Xuxiupa/dual-mcu-sorter/docs/数据流时序图.png

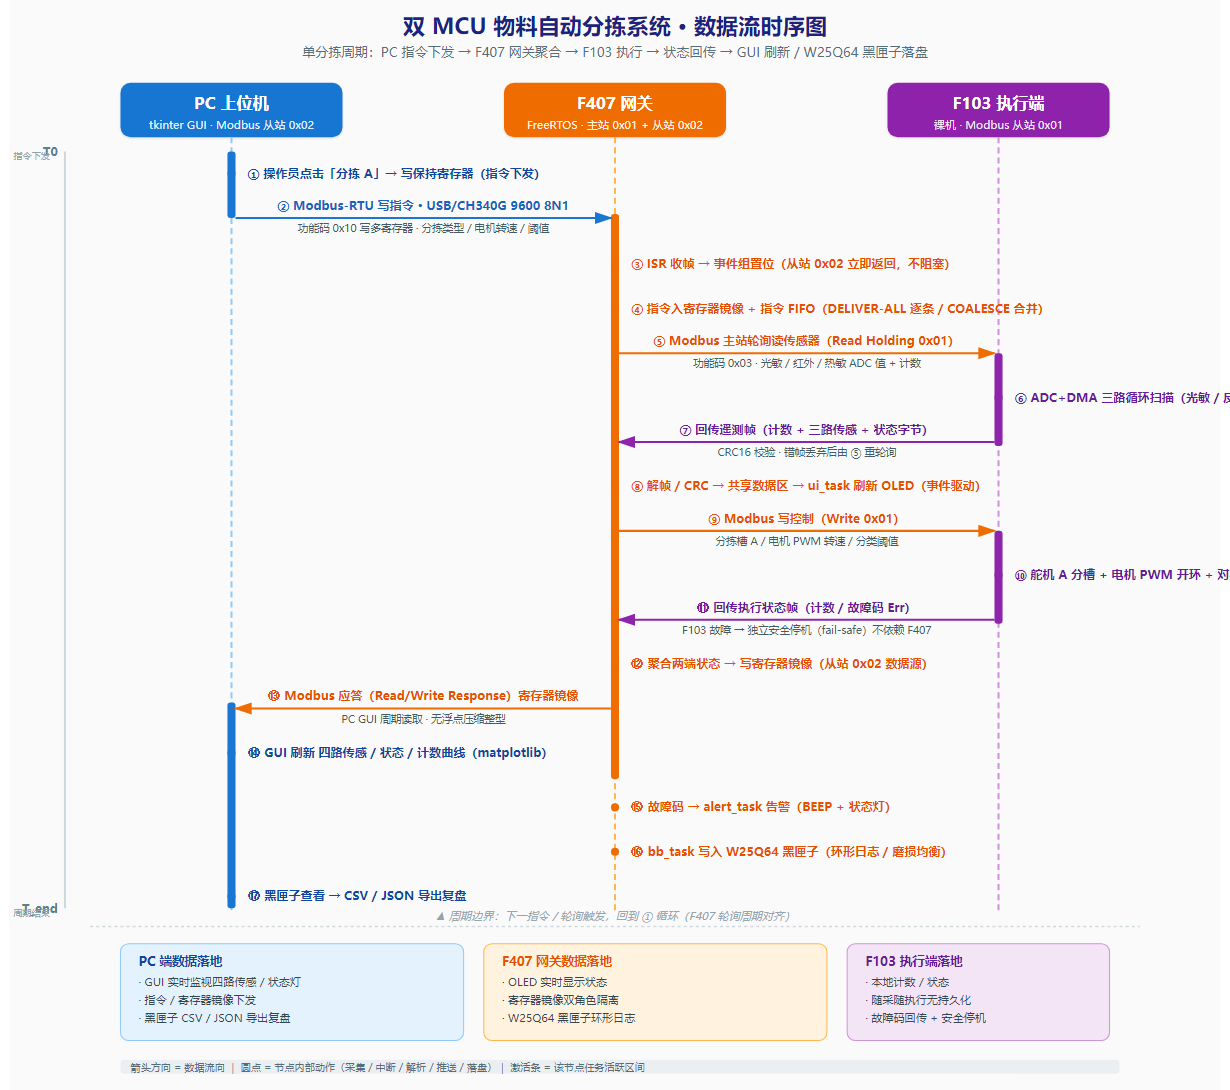
docs/数据流时序图.png
