Xuxiupa/dual-mcu-sorter/docs/架构图.png

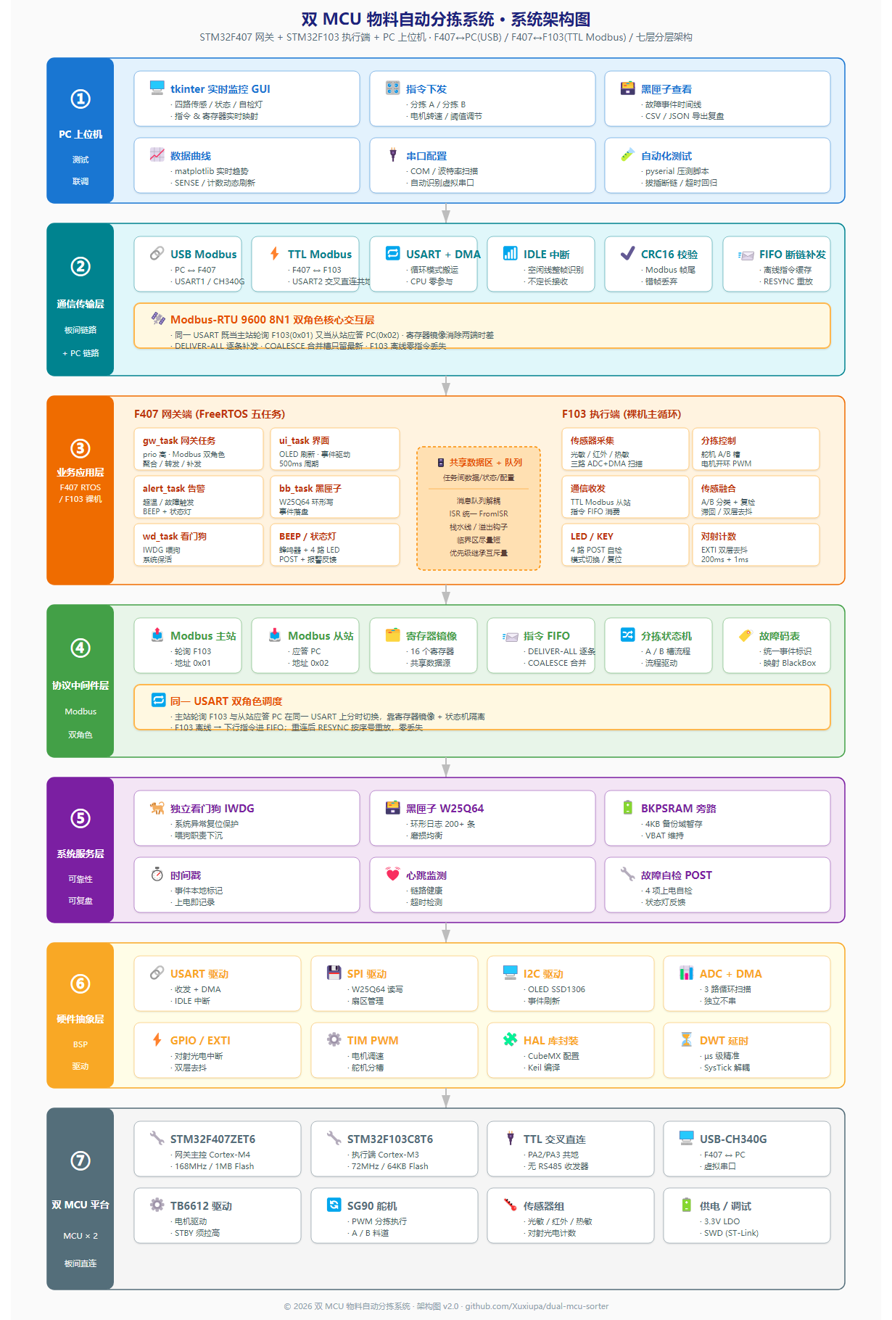
docs/架构图.png
