Xuxiupa/dual-mcu-sorter/f103_executor/Core/Inc/main.h

#define ENCODER_A_Pin GPIO_PIN_0
#define ENCODER_A_GPIO_Port GPIOA
#define ENCODER_B_Pin GPIO_PIN_1
#define ENCODER_B_GPIO_Port GPIOA
#define ADC_IN_BAT_Pin GPIO_PIN_4
#define ADC_IN_BAT_GPIO_Port GPIOA
#define PWM_SERVO_Pin GPIO_PIN_6
#define PWM_SERVO_GPIO_Port GPIOA
#define PWM_MOTOR_Pin GPIO_PIN_8
#define PWM_MOTOR_GPIO_Port GPIOA
#define KEY_INT_Pin GPIO_PIN_12
#define KEY_INT_GPIO_Port GPIOA
#define KEY_INT_EXTI_IRQn EXTI15_10_IRQn
#define LED1_Pin GPIO_PIN_3
#define LED1_GPIO_Port GPIOB
#define LED2_Pin GPIO_PIN_4
#define LED2_GPIO_Port GPIOB
#define BEEP_Pin GPIO_PIN_5
#define BEEP_GPIO_Port GPIOB
#define BEEPB6_Pin GPIO_PIN_6
#define BEEPB6_GPIO_Port GPIOB
