Xuxiupa/dual-mcu-sorter/f103_executor/Core/Src/main.c

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
/* Includes ------------------------------------------------------------------*/
#include "main.h"
#include "adc.h"
#include "dma.h"
#include "iwdg.h"
#include "tim.h"
#include "usart.h"
#include "gpio.h"

/* USER CODE BEGIN Includes */
#include <stdio.h>   /* fputc 里的 FILE *f 需要 */
#include "app_main.h"

/* USER CODE END Includes */


void SystemClock_Config(void);
/* USER CODE BEGIN 0 */


int fputc(int ch, FILE *f)
{
    HAL_UART_Transmit(&huart1, (uint8_t *)&ch,1,0xFFFF);
    return ch;
}


/* USER CODE END 0 */

/**
  * @brief  The application entry point.
  * @retval int
  */
int main(void)
{

  /* USER CODE BEGIN 1 */
  /* 释放 PB3/PB4 的 JTAG 功能，改作普通 GPIO（电机方向脚 AIN1/AIN2 用）。
     注意：只关 JTAG、保留 SWD(PA13/PA14)，否则无法再调试下载。 */
  __HAL_RCC_AFIO_CLK_ENABLE();
  uint32_t mapr = AFIO->MAPR;
  mapr &= ~AFIO_MAPR_SWJ_CFG;   /* 清除 SWJ_CFG[26:24] */
  mapr |=  0x02000000U;         /* 010 = 关闭 JTAG，保留 SWD */
  AFIO->MAPR = mapr;
  /* USER CODE END 1 */

  /* MCU Configuration--------------------------------------------------------*/

  /* Reset of all peripherals, Initializes the Flash interface and the Systick. */
  HAL_Init();

  /* Configure the system clock */
  SystemClock_Config();

  /* Initialize all configured peripherals */
  MX_GPIO_Init();
  MX_DMA_Init();
  MX_ADC1_Init();
  MX_TIM1_Init();
  MX_TIM2_Init();
  MX_TIM3_Init();
  MX_USART1_UART_Init();
  MX_USART2_UART_Init();
  MX_IWDG_Init();
  /* USER CODE BEGIN 2 */
  app_main();   /* 启动应用主循环：Modbus 从站 + 电机控制。必须在 USART2 初始化之后调用 */

  /* USER CODE END 2 */

  /* Infinite loop */
  /* USER CODE BEGIN WHILE */
  while (1)
  {
    /* USER CODE END WHILE */

    /* USER CODE BEGIN 3 */

  }
  /* USER CODE END 3 */
}

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
