Xuxiupa/dual-mcu-sorter/(commit log)

2026-08-31 feat: 双MCU物料自动分拣系统初始提交
2026-08-31 docs: README 优化与代码注释精修
2026-09-03 docs: 新增数据流时序图 + README 联动架构图/时序图 + 清理冗余文档
